Soberat/MIDI-Controller/Traktor Pro Overview.md

# What is Traktor Pro?

Traktor Pro is a program created by Native Instruments used by DJs all over the world. It is full of useful features and most importantly for us it features a very customizable MIDI Input/Output mapping, allowing us to both control and view almost any part of the program from our controller.

Imgur

Any DJ program is composed of 3 main things:
- decks, usually two - those are parts where you load the music you're gonna play and manipulate it,\
Imgur
- mixer - controls things like filters, gain and volume,\
Imgur
- browser - used to browse your music collection.\
Imgur

With a MIDI controller you can control all those things without laying a finger on your laptop.

# Why Traktor Pro?

Traktor Pro is the only DJ program on the market that allows us to map any functionality we need to a input/output signal for the controller.
Functionalities include:
- play/pause buttons,
- cue buttons - allows the user to easily preview a loaded track,
- volume/gain potentiometers,
- crossfader potentiometer - controlls the mixing of decks,
- load buttons - load a track selected in the browser into a given deck,
- modifier buttons - a modifier can change a different input behavior based on its' state,
- browser rotary encoder - used for quick browsing of track library,
- play/pause LEDs,
- track end LEDs - warning a user that a track is about to end,
- volume meters - showing the user wheter the music is playing on a deck and if it is playing correclty (it is not playing too loud for given audio interface)
- phase meter - used to sync up tracks.
