Soberat/MIDI-Controller/(commit log)

2021-01-03 Add LEDs as outputs
2021-01-03 Add webm of LEDs
2021-01-12 Add Numark Mixdeck protocol interpreter
    Now using a proprietary protocol interpreter written by us we can display additional information on our controller like time or track title.
2021-01-21 Add support for I2S interfaces
    Designed using Teensy Audio Library
2021-01-21 Move debug message to TrackDataHandler
    This fixes an issue where ram would fill up because we weren't using the F() macro.
    [MIDI-Controller.ino, TrackDataHandler.cpp]
